Konat23/Biocarding/README.md

# Grupo Biocarding
- Juan Sebastian Guerrero Peña
- Rafael Santiago Suarez Gil
- Daniel Augusto García Gomez
## Parte 1: ELECTROCARDIOGRAFO ANALÓGICO DE UNA DERIVACION.
Este trabajo desarrollo un electrócardiografo de bajo costo y fácil uso capaz de adquirir, amplificar y procesar senales ECG. El sistema incorpora diversos componentes, incluyendo un amplificador de instrumentacion, filtros pasa bajos y pasa altos, un amplificador de ganancia y un circuito de desplazamiento de voltaje. Estos componentes se integran para garantizar una adquisicion precisa de señales y reducir la interferencia de ruido durante el proceso de medicion.
### Esquematico general del circuito


###  Plano 2D del diseno de las dos capas de la PCB 


###  Montaje PCB con los componentes soldados


### Senal de derivaciÓn I (Osicloscopio)


### Señar recibida softare del computador


## Parte 2: MEDIDOR DE FRECUENCIA CARDIACA CON DIAGNOSTICO AUTOMATIZADO
En este informe se documenta el desarrollo de un proyecto basado en la mejora del electrocardiógrafo analógico de una derivación previamente diseñado. En el proyecto anterior, se logró la implementación exitosa de un electrocardiógrafo analógico capaz de registrar la señal de electrocardiograma (ECG) de una persona. En esta segunda etapa, se utilizó la señal ECG capturada para desarrollar un sistema digital que permitiera contar y diagnosticar digitalmente la frecuencia cardíaca y detectar anomalías como la bradicardia y taquicardia. Además, se incorporó un componente adicional: un generador de sonido para emitir un bip en cada conteo de pulso.

### Esquematico general delcircuito


### Componentes extras conectados al arduino


### Diseno de PCB en una capa


### PCB con los componentes soldados


### Logica del código desarrollado


### Visualizacion en pantalla LCD mientras se hace el conteo


### Visualizacion en pantalla LCD despues del conteo
