Konat23/Biocarding/Papers/Parte_1.pdf

ELECTROCARDIOGRAFO ANAL ´ | OGICO DE ´

# UNA DERIVACION. GRUPO BIOCARDING ´

Juan Sebastian Guerrero Pe ´ | na˜
Universidad Industrial de Santander Bucaramanga, Colombia
juan2190435@correo.uis.edu.co

Rafael Santiago Suarez Gil ´
Universidad Industrial de Santander Bucaramanga, Colombia
rafael2190433@correo.uis.edu.co

Daniel Augusto Garc´ıa Gomez
Universidad Industrial de Santander Bucaramanga, Colombia
daniel2190436@correo.uis.edu.co
I. INTRODUCCION´
El monitoreo y analisis de se ´ | nales electrocardiogr ˜ | aficas ´
(ECG) han adquirido una creciente importancia en el campo
de la salud y la medicina en los ultimos a ´ | nos. Estas se ˜ | nales ˜
proporcionan informacion valiosa sobre el funcionamiento del ´ corazon y permiten detectar y diagnosticar una amplia gama ´ de condiciones cardiovasculares. Con el objetivo de mejorar el acceso y la portabilidad de los dispositivos de monitoreo card´ıaco, se ha emprendido un proyecto enfocado en el diseno˜
y montaje de un electrocardiografo de una derivaci ´ | on. ´
Este trabajo, tiene como objetivo desarrollar un electro-
cardiografo de bajo costo y f ´ | acil uso capaz de adquirir, am- ´
plificar y procesar senales ECG. El sistema incorpora diversos ˜ componentes, incluyendo un amplificador de instrumentacion, ´ filtros pasa bajos y pasa altos, un amplificador de ganancia y un circuito de desplazamiento de voltaje. Estos componentes
se integran para garantizar una adquisicion precisa de se ´ | nales ˜
y reducir la interferencia de ruido durante el proceso de medicion. ´
Ademas, se ha desarrollado una aplicaci ´ | on para visualizar ´
y analizar las senales ECG adquiridas en tiempo real. ˜
Mediante la implementacion de este electrocardi ´ | ografo ´
portatil, el grupo ”Biocarding” busca contribuir al avance de ´ la tecnolog´ıa de monitoreo cardiovascular, con el potencial
de mejorar la accesibilidad a la atencion m ´ | edica y promover ´
la deteccion temprana de anomal ´ | ´ıas card´ıacas. Las secciones
siguientes de este documento presentan la metodolog´ıa de
diseno, la configuraci ˜ | on experimental, los resultados obtenidos ´
y la discusion, ofreciendo una visi ´ | on completa de los resulta- ´
dos del proyecto.

II. METODOLOG´IA

### 1. Definicion de requisitos y especificaciones: ´

Para esta etapa del proyecto, se utilizaron las especificaciones establecidas en la norma internacional ISO 60601-2-47:2012 para como referencia. Estas especificaciones incluyen:
- Ganancia: Se establecio una ganancia de 1000V/V. ´
- Frecuencias de corte: Se configuraron filtros pasa altas y pasa bajas con frecuencias de corte de 0.5Hz y 40Hz, respectivamente.
- Rango dinamico de entrada de ±2.5mV. ´
- Offset DC de ±200mV.
- CMRR (Common Mode Rejection Ratio) mayor a 90dB (a 60Hz).
- Incluir circuito de proteccion de pierna derecha. ´ Adicionalmente se tuvo que sumar 2.5V DC a la senal de ˜ salida para que la senal pudiera ser captada correctamente por ˜ una tarjeta de adquisicion de datos (en este caso un Arduino ´ uno).
2. Diseno del circuito: El dise ˜ | no del circuito se realiz ˜ | o con ´
base en las especificaciones definidas anteriormente, llegando al esquematico mostrado en la figura 1 ´

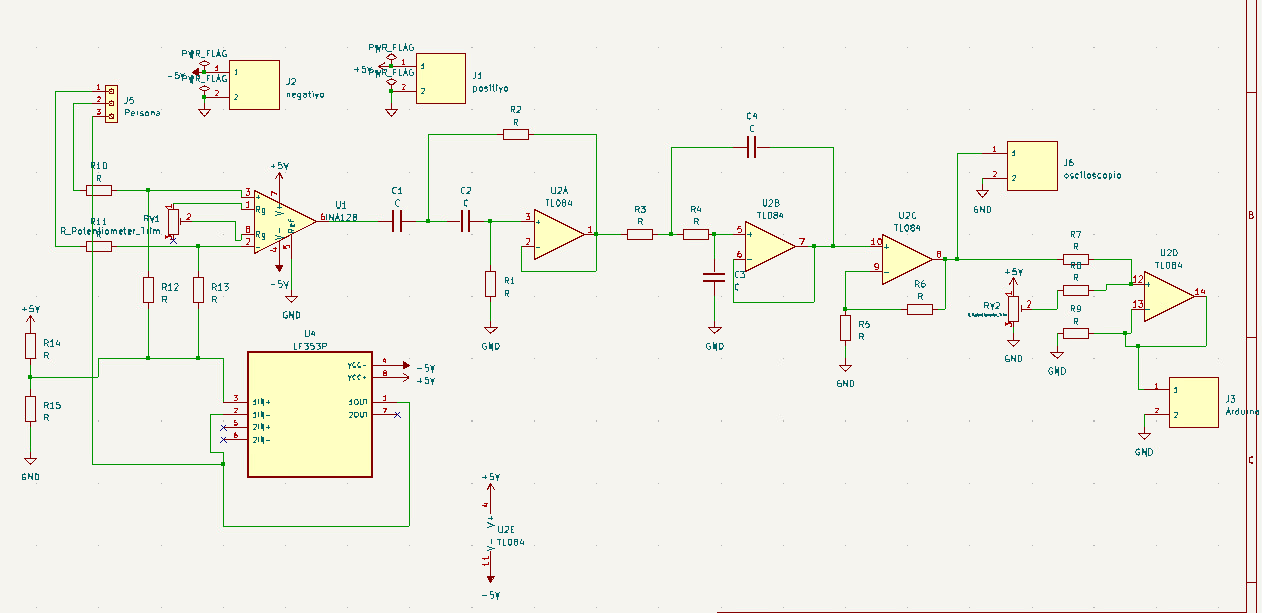
[picture p1: figure]

Fig. 1. Esquematico general del circuito ´

A continuacion se explicar ´ | a a detalle cada una de las etapas ´
del circuito.
- Pre-amplificacion´
Para la etapa de preamplificacion se hizo uso del amplifi- ´ cador de instrumentacion INA128, este integrado permite ´
amplificar senales diferenciales muy peque ˜ | nas, como es ˜
el caso de las senales el ˜ | ectricas del cuerpo humano. ´
Para cumplir con las especificaciones se definio una ´ ganancia de 40 [V/V] para la etapa de pre-amplificacion, ´ por lo que la resistencia entre los pines 1 y 8 se establecio´ con un trimmer en 1282 [Ω] de acuerdo a la expresion´ de ganancia indicada por el fabricante [1]:

ganancia = 1 +

| 50000
| R

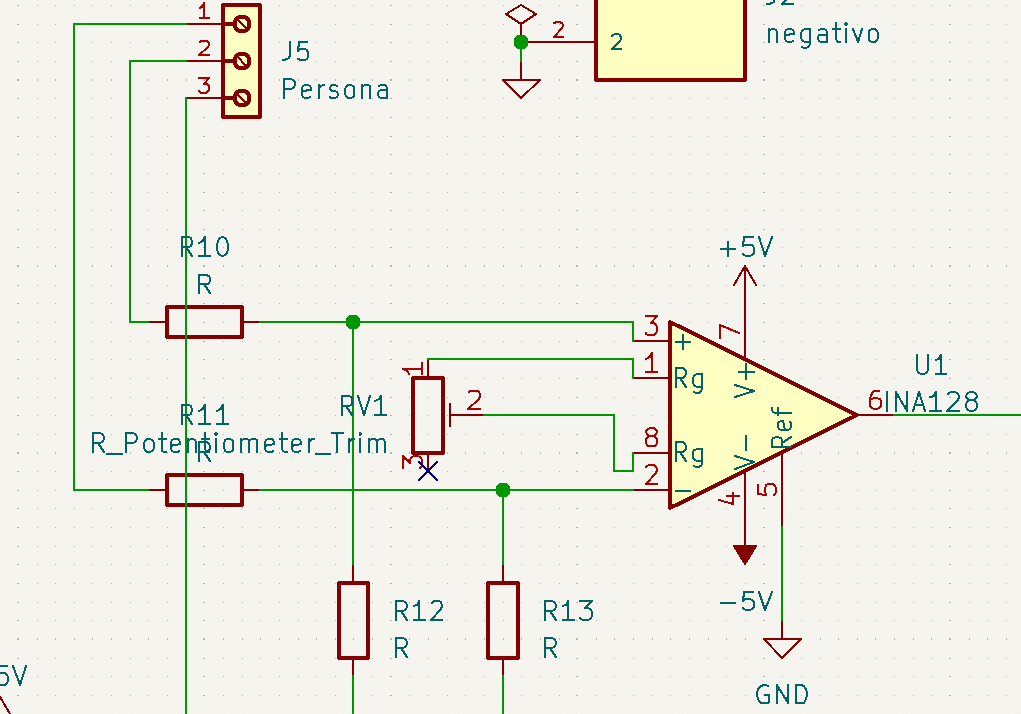
[picture p2: figure]

Fig. 2. Pre-amplificacion INA128 ´

- Filtrado de frecuencias
Para el diseno del filtro pasa bajas con frecuencia de corte ˜ 40Hz y el filtro pasa altas con frecuencia de corte 0.5Hz se utilizaron filtros activos de segundo orden y ganancia unitaria con configuracion Sallen-Key. ´
Con ayuda del programa FilterPro de Texas Instruments se obtuvieron los valores de los componentes pasivos del filtro y se uso el integrado TL084 para su imple- ´ mentacion. Para el filtro pasa altas se usaron dos resisten- ´ cias, una de 47k[Ω] conectada a GND, otra de 22k[Ω] y dos capacitores de 10[µF] Para el filtro para bajas se usaron dos resistencias de 2.8k[Ω] y dos capacitores, uno de 1[µF] y otro de 2.2[µF].

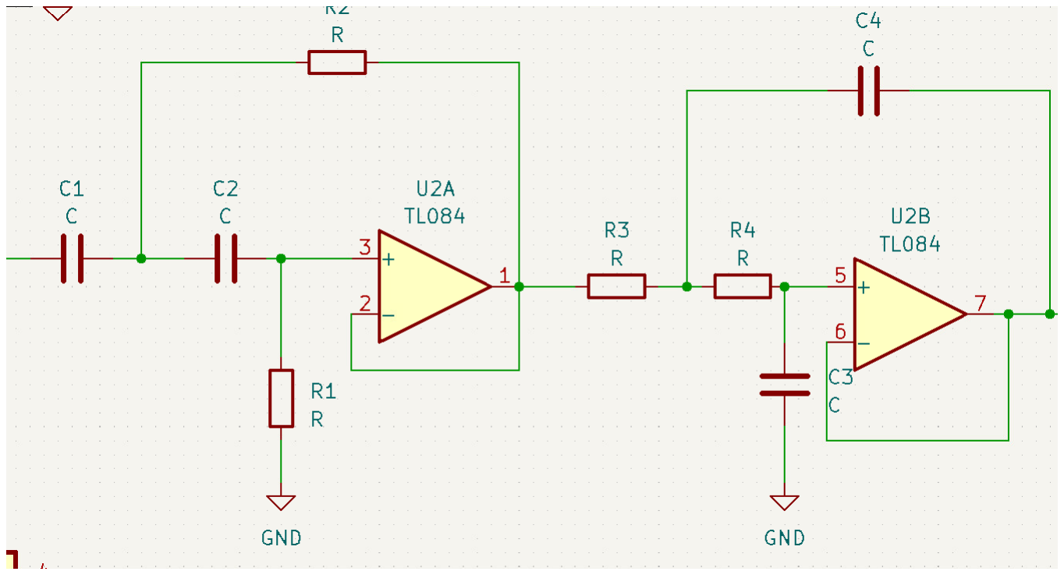
[picture p3: figure]

Fig. 3. Filtros activos

- Amplificacion´
Para esta etapa se disen˜o un amplificador no inversor ´ de ganancia 51[V/V] (aproximadamente 50[V/V]) para cumplir con la ganancia de 1000[V/V] a la salida del arduino, para implementar este amplificador se hizo uso del integrado TL084 y dos resistencias, una de 100k[Ω] (correspondiente a la resistencia R6 de la figura 4) y una de 2k[Ω] (correspondiente a la resistencia R5 de la figura 4)
Vout = 1 +

R6
R5

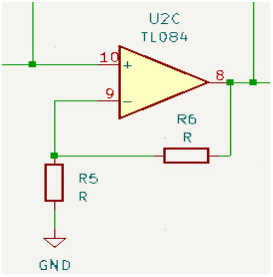
[picture p4: figure]

Fig. 4. Amplificacion´

- Sumador
Esta etapa se diseno con el fin de a ˜ | nadir un offset de 2.5V ˜
a la senal medida,amplificada y filtrada posteriormente ˜ para cumplir con el requisito del aplicativo para visualizar
la senal en el programa. Para el dise ˜ | no se utilizaron 2 ˜
resistencias iguales de 2k[Ω] (R7,R6), una resistencia conectada a GND de 100k[Ω] (R9) con el fin de disminuir el paso de corriente y una retroalimentacion completa con ´ Rf=0[Ω]
V o =

Vin
2

+ 2.5

Debido a que esta configuracion aten ´ | ua la se ´ | nal a la mitad ˜
se tuvo que poner una ganancia de 40[V/V] en la etapa de pre-amplificacion. ´

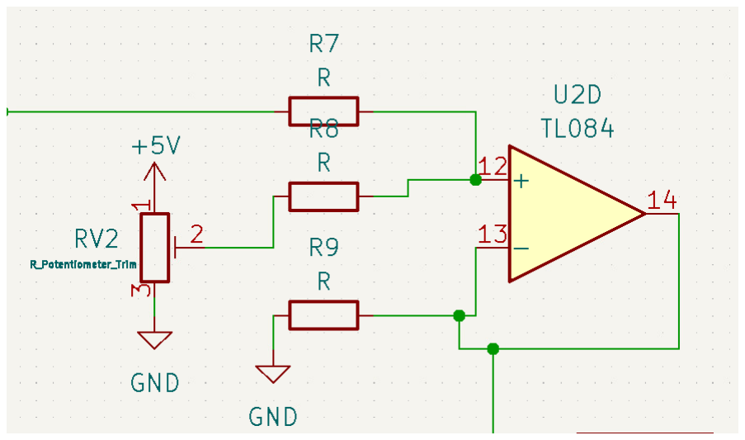
[picture p5: figure]

Fig. 5. Circuito Sumador

- Pierna derecha
El circuito protector de pierna derecha es para proteger al paciente de la posibilidad de sufrir descargas electricas ´ peligrosas durante el proceso de medicion. este se utiliza ´ para establecer un punto de referencia de voltaje estable en el sistema de medicion del ECG. Conecta la pierna ´ derecha del paciente a tierra para evitar que las senales ˜
de interferencia, como el ruido electrico de la red el ´ | ectrica ´
o los movimientos del paciente, afecten la precision de ´ las mediciones del ECG.

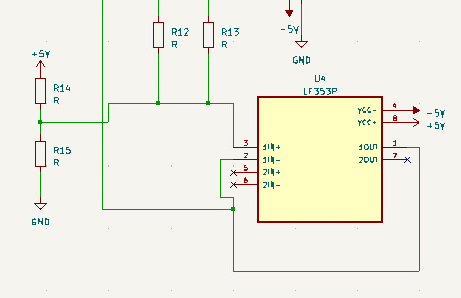
[picture p6: figure]

Fig. 6. Circuito de proteccion de pierna derecha ´

### 3. Montaje del prototipo:

Se procedio al dise ´ | no y montaje del circuito en una PCB de ˜
dos capas, siguiendo las conexiones definidas en el diseno˜ del circuito.

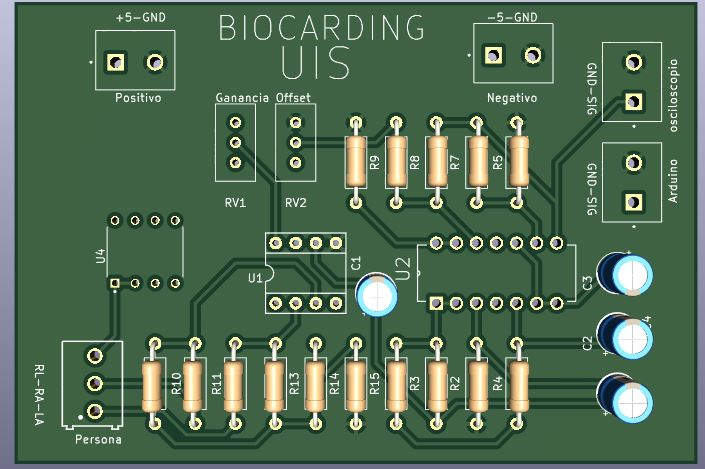
[picture p7: figure]

Fig. 7. Modelo 3D del diseno de la PCB ˜

Se intento ubicar los componentes de tal forma que las ´ pistas fueran de la menor longitud posible, a demas se ubicaron ´
planos de GND, +5V y -5V para evitar al maximo las p ´ | erdidas. ´

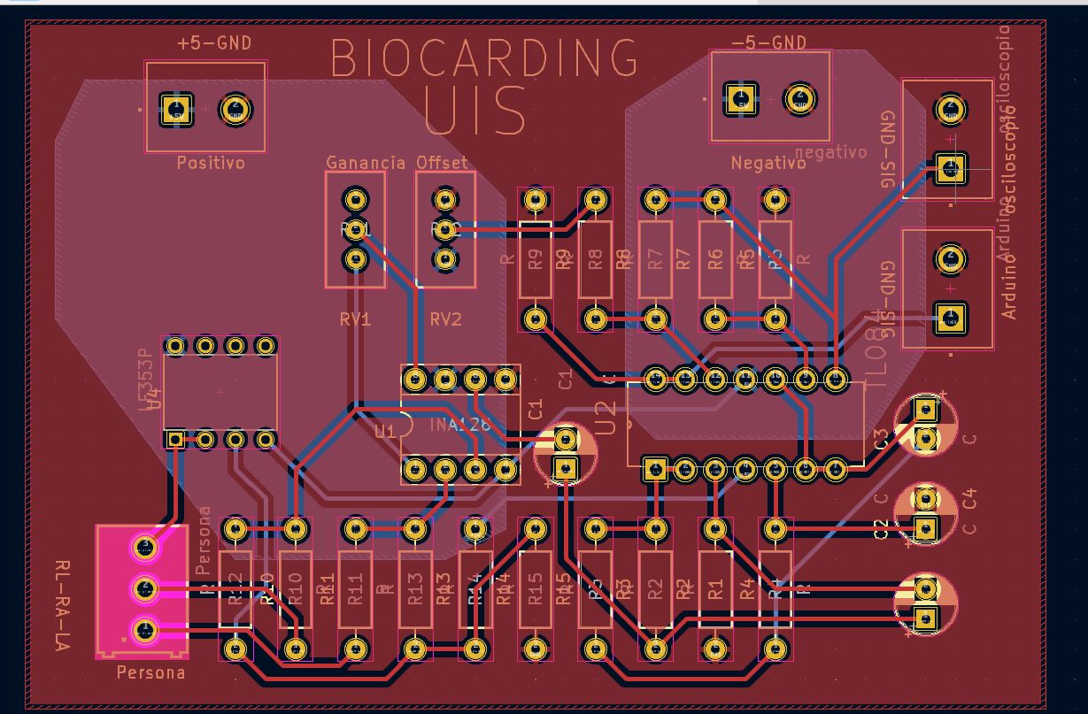
[picture p8: figure]

Fig. 8. Plano 2D del diseno de las dos capas de la PCB ˜

Por falta de experiencia se ubicaron la mayor´ıa de pistas en la capa superior, lo que dificulto bastante el proceso de ´ soldadura.

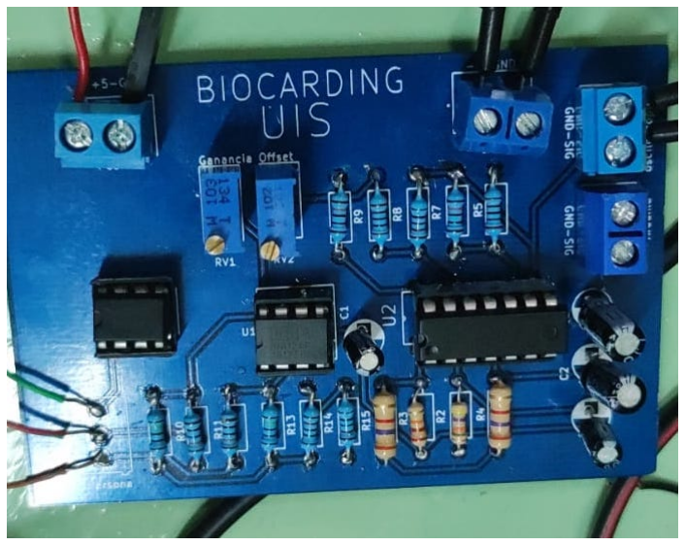
[picture p9: figure]

Fig. 9. PCB con los componentes soldados

4. Calibracion y pruebas preliminares: ´
Se realizaron pruebas utilizando una fuente sinusoidal de 500mV a 20Hz para verificar el funcionamiento de cada etapa
del circuito. Ademas, se verific ´ | o que la se ´ | nal final estuviera ˜
dentro de los rangos deseados y con una ganancia adecuada para su correcta lectura. Se llevaron a cabo ajustes de ganancia tanto en el INA como en el amplificador con ganancia de 50 para lograr la calibracion adecuada. ´

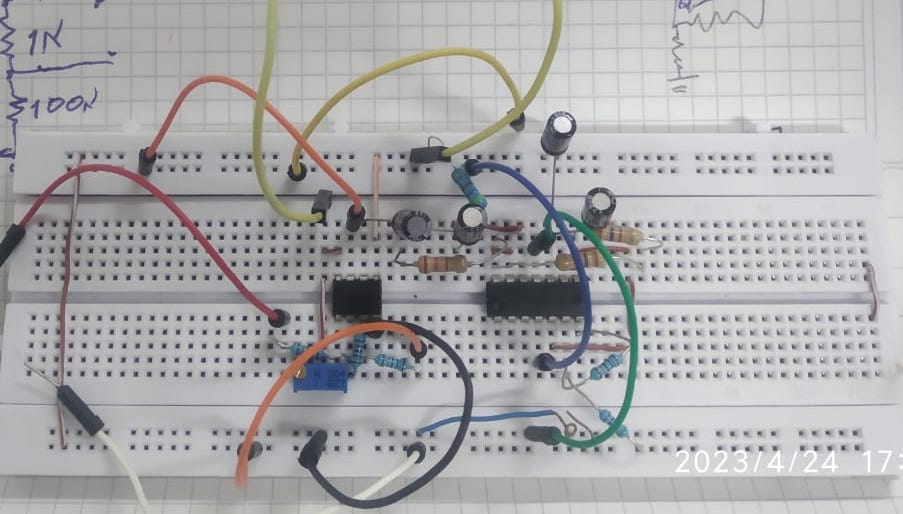
[picture p10: figure]

Fig. 10. Circuito para pruebas y calibracion´

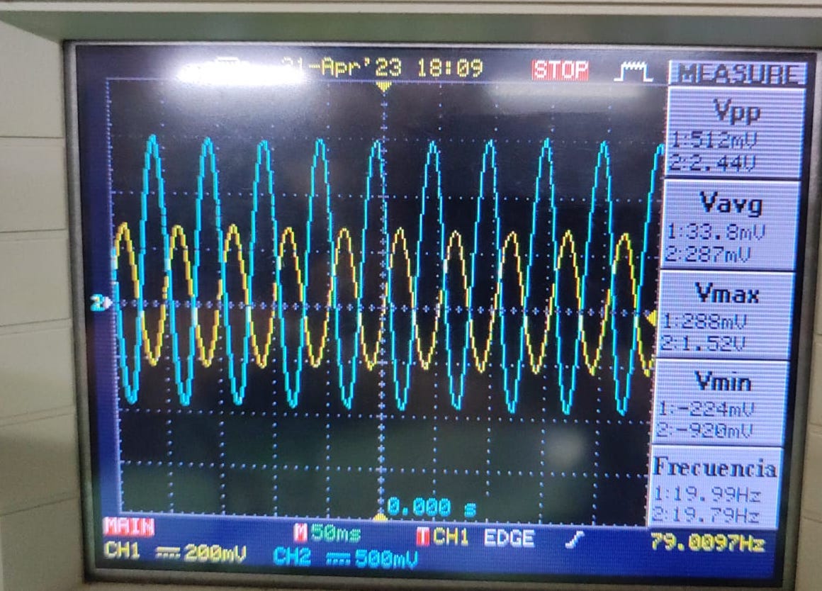
[picture p11: figure]

Fig. 11. Prueba de ganancia final del circuito

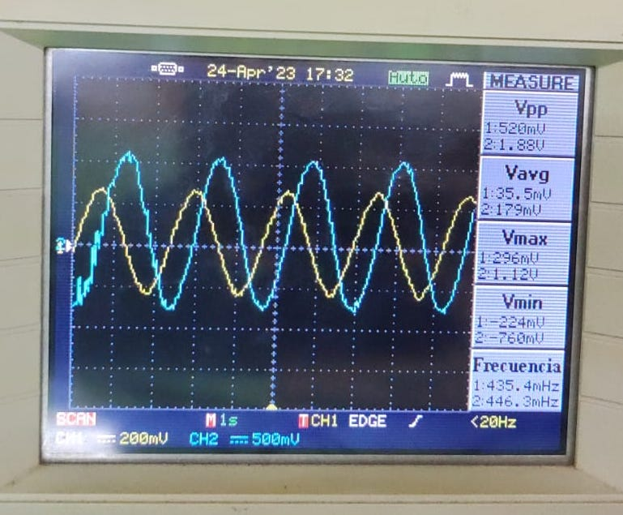
[picture p12: figure]

Fig. 12. Salida circuito a la frecuencia de corte pasa altas

Fig. 13. Salida circuito a la frecuencia de corte pasa bajas

La ganancia total del circuito y las ganancias en las frecuencias de corte se adecuaron para cumplir con las especificaciones.
5. Desarrollo del software de registro senal ECG en ˜ computador:

Nota:Todos los programas estan disponibles en github [ [2]] ´ Primero se creo un programa que permitiera leer los datos mediante una de las entradas analogicas del arduino, ´
esta programacion se hace en C++, este c ´ | odigo es bastante ´
sencillo por las facilidades que tiene a arduino

Basados en el v´ıdeo tutorial de [3], Se desarrollo una ´ programa utilizando el lenguaje Python para visualizar la senal ˜ capturada por el circuito en el computador. Este script permitio´ leer los datos que esta enviando el arduino al computador, y representarlos graficamente como se muestra en la figura [14]. ´

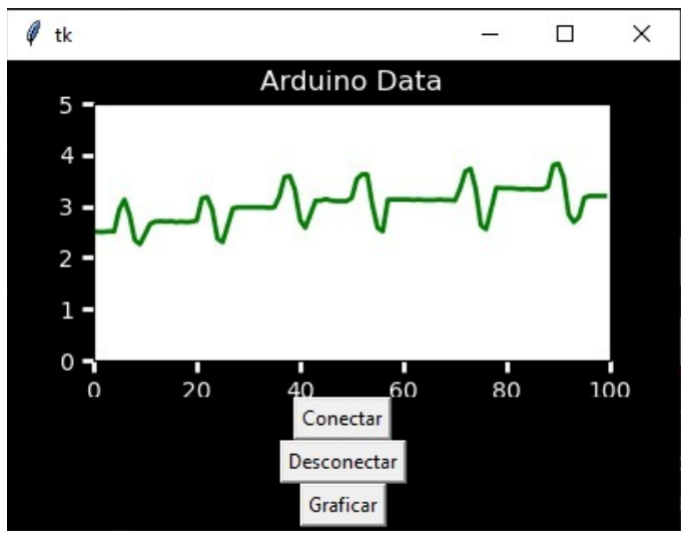
[picture p13: figure]

Fig. 14. Senal vista en el computador ˜

III. RESULTADOS
En relacion a los resultados experimentales, se identificaron ´ dificultades en el funcionamiento del circuito debido a problemas en la PCB. A pesar de estos contratiempos, es importante
destacar que se logro avanzar en la construcci ´ | on del circuito y ´
realizar las pruebas experimentales en protoboard, obteniendo los siguientes resultados.

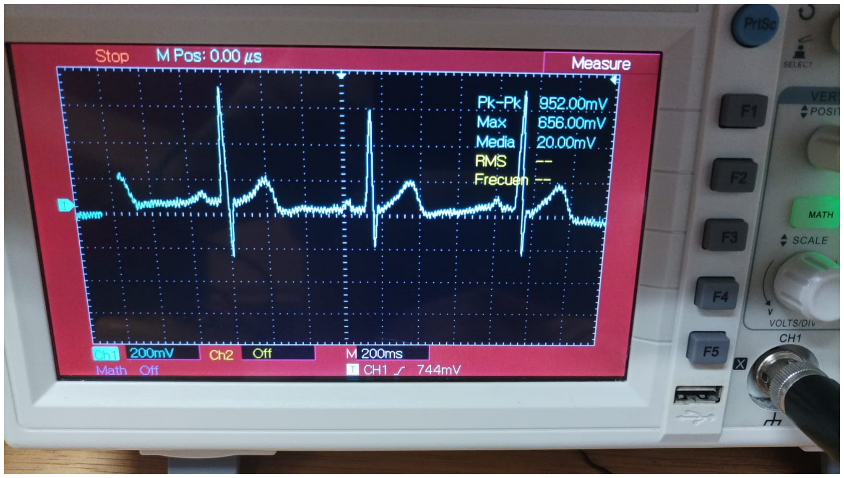
[picture p14: figure]

Fig. 15. Senal de derivaci ˜ | on I obtenida con el circuito en protoboard ´

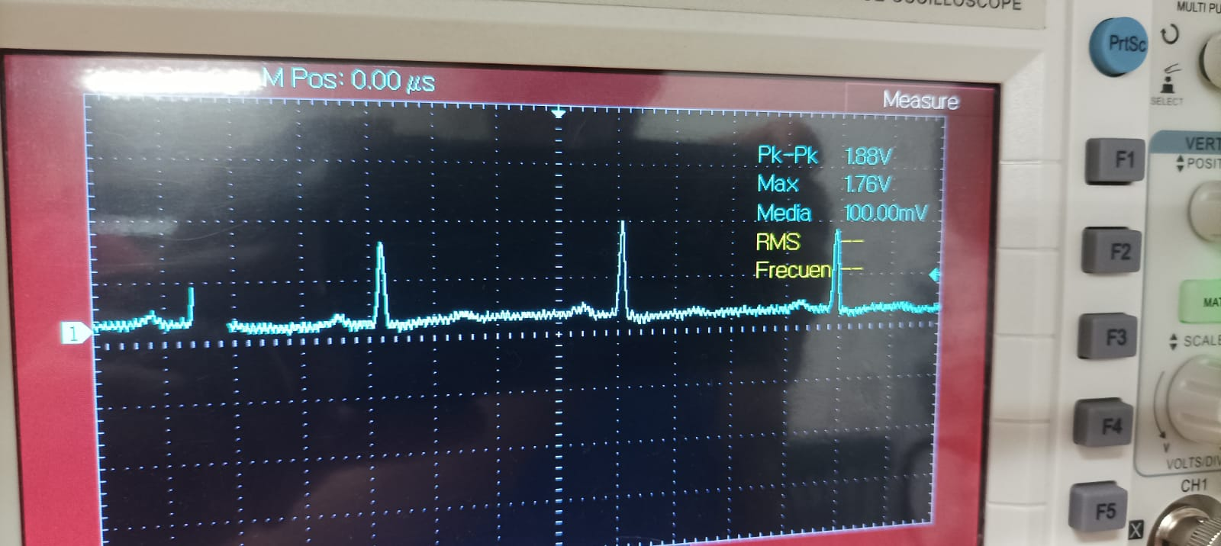
[picture p15: figure]

Fig. 16. Senal de derivaci ˜ | on II obtenida con el circuito en protoboard ´

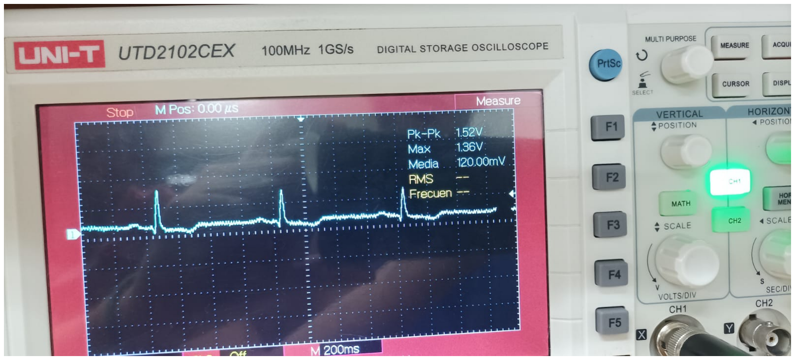
[picture p16: figure]

Fig. 17. Senal de derivaci ˜ | on III obtenida con el circuito en protoboard ´
Aunque el circuito no funciono seg ´ | un lo esperado, esta ´
experiencia ha brindado valiosas lecciones y oportunidades de aprendizaje. Como equipo, nos comprometemos a investigar y resolver el problema identificado en la PCB para asegurar el correcto funcionamiento en la siguiente etapa del proyecto. Reconocemos que la investigacion y el desarrollo de proyectos ´ a menudo presentan desaf´ıos, y estamos decididos a seguir trabajando y mejorando para lograr nuestros objetivos.

IV. CONCLUSIONES
- El montaje del prototipo en una PCB de dos capas facilito´
la integracion de los componentes y la minimizaci ´ | on de ´
interferencias y ruidos.
- La etapa de calibracion y pruebas preliminares fue fun- ´ damental para verificar el correcto desempeno de cada ˜ componente del sistema y garantizar mediciones dentro de los rangos deseados.
- El desarrollo del aplicativo utilizando Arduino para vi-
sualizar la senal ECG brind ˜ | o una interfaz amigable y ´
accesible para el usuario, facilitando la interpretacion y ´ analisis de los datos obtenidos. ´
- El uso de programas de diseno y simulaci ˜ | on demostr ´ | o ser ´
una estrategia efectiva para seleccionar los componentes y valores adecuados, asegurando el filtrado y amplificacion´ adecuada de las senales ECG. ˜

REFERENCES

[1] Precision, low power instrumentation amplifiers ina128 ina129. BURR-BROWN. [Online]. Available: https://pdf1.alldatasheet.com/datasheetpdf/view/56683/BURR-BROWN/INA128.html
[2] S. | Guerrero, | “Biocarding,” | 05 | 2023. | [Online]. | Available:
https://github.com/Konat23/Biocarding
[3] M. Efren. Interfaz grafica en python enviar y recibir datos anal ´ | ogicos de ´
arduino. Youtube. [Online]. Available: https://youtu.be/DJY9TFxrYbM
