Konat23/Biocarding/Code_Project_2/Contador_pulsos/Maquina de estados Contador de Pulsos.jpg

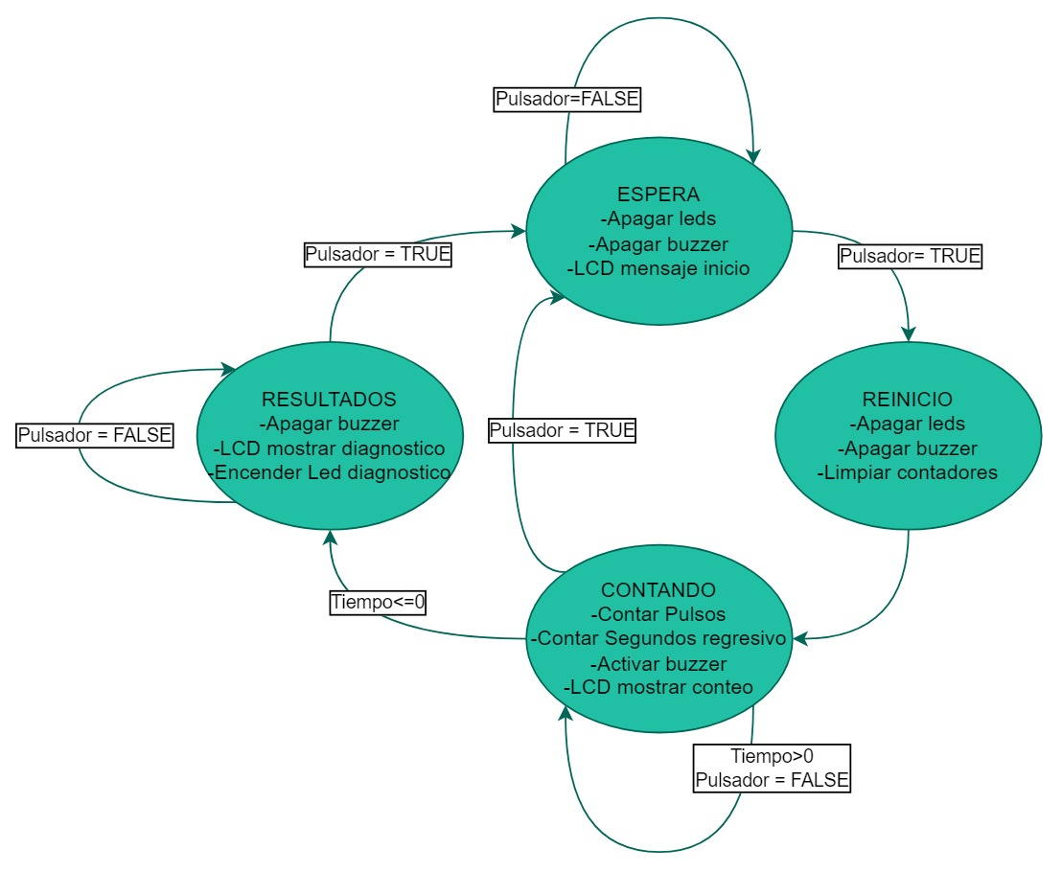
Code_Project_2/Contador_pulsos/Maquina de estados Contador de Pulsos.jpg
