Konat23/Biocarding/Code_Project_1/comunication.py

import serial, serial.tools.list_ports
from threading import Thread, Event
from tkinter import StringVar


class Comunication():
    def __init__(self, *args):
        super().__init__(*args)
        self.datos_recibidos = StringVar()
        self.arduino = serial.Serial()
        self.arduino.timeout = 0.5
        
        self.baudrates = ['9600']
        self.puertos = []
        
        self.señal = Event()
        self.hilo = None
        
    def puertos_disponibles(self):
        self.puertos = [port.device for port in serial.tools.list_ports.comports()]
    
    def conexion_serial(self):
        try:
            self.arduino.open()
        except:
            pass
        if self.arduino.is_open:
            self.iniciar_hilo()
            print('conectando')
            
    def enviar_Datos(self, data):
        if self.arduino.is_open:
            self.datos = str(data) + "\n"
            self.arduino.write(self.datos.encode())
        else: 
            print('Error')
    def leer_datos(self):
        try:
            while(self.señal.isSet() and self.arduino.is_open):
                data = self.arduino.readline().decode("utf-8").strip()
                if len(data)>1:
                    self.datos_recibidos.set(data)
        except TypeError:
            print("No se estan recibiendo datos")
    
    def iniciar_hilo(self):
        self.hilo = Thread(target = self.leer_datos)
        self.hilo.setDaemon(1)
        self.señal.set()
        self.hilo.start()
    def stop_hilo(self):
        if(self.hilo is not None):
            self.señal.clear()
            self.hilo.join()
            self.hilo = None
    def desconectar(self):
        self.arduino.close()
        self.stop_hilo()
        
puertos = [port.device for port in serial.tools.list_ports.comports()]
print(puertos)
